danielsrualesc/CDIO3_EqE5_TELECOF/02_Hardware/Mecanica_Sistema/216c6802-5bb0-475e-80d3-5a92c7b59e43.jpeg

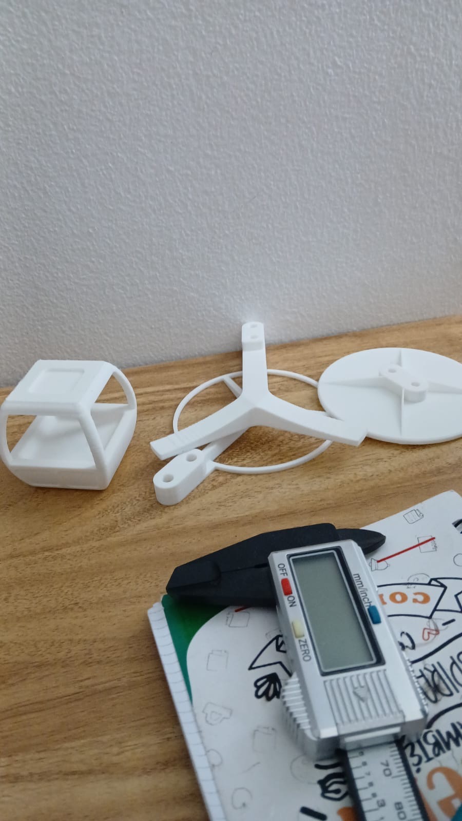
02_Hardware/Mecanica_Sistema/216c6802-5bb0-475e-80d3-5a92c7b59e43.jpeg
