danielsrualesc/CDIO3_EqE5_TELECOF/02_Hardware/Mecanica_Sistema/ec7a891b-7618-41e1-a918-f9e406c41ac0.jpeg

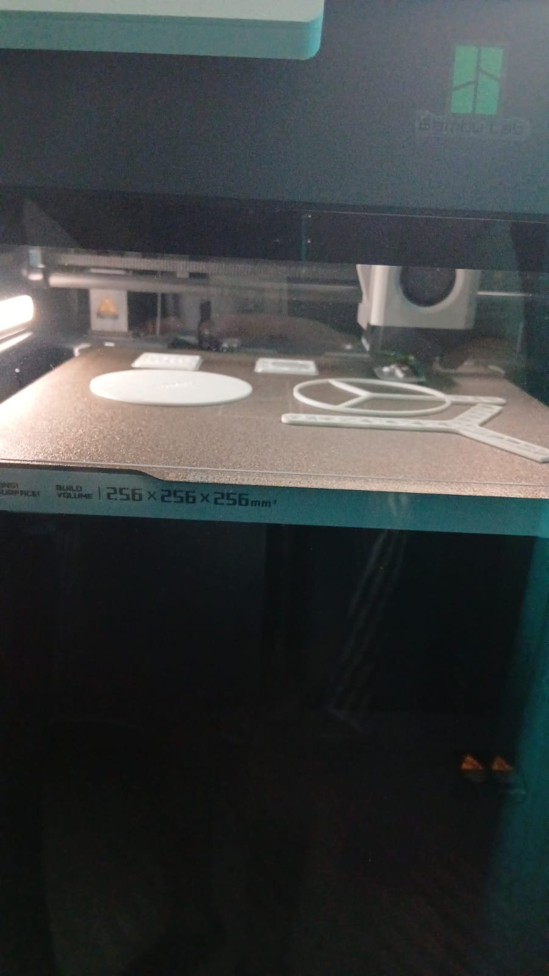
02_Hardware/Mecanica_Sistema/ec7a891b-7618-41e1-a918-f9e406c41ac0.jpeg
