danielsrualesc/CDIO3_EqE5_TELECOF/04_Dossier/Informe_Avance_.pdf

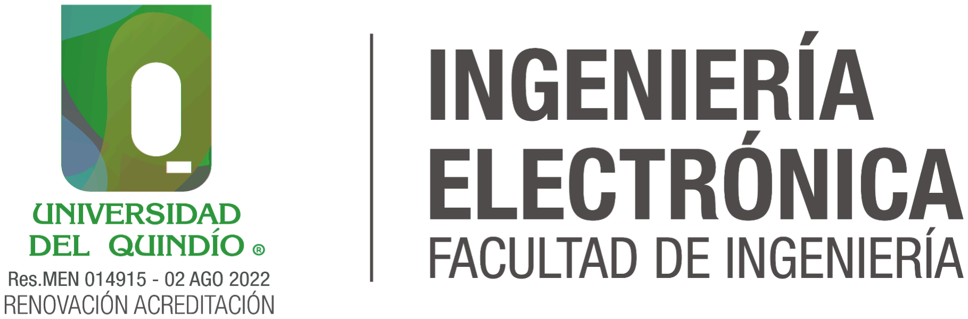
[picture p3: figure]

## FACULTAD DE INGENIERÍA PROGRAMA DE INGENIERÍA ELECTRÓNICA

## DOCUMENTO DE AUDITORÍA CDIO Informe de Avance Tecnico - PMV

## Proyecto:

### TELECOF

### Equipo de Ingeniería : Integrante 1 (Daniel MAHD Master) Integrante 2 (Kevin Daniel Hardware Lead) Integrante 3 (Erick, Robin Software Lead)

### Corte de Auditoría: Semana 12 - Fase Operación Fecha de Entrega: 4/05/2026

Universidad del Quindío
2026

## 1. Resumen Ejecutivo

Desarrollar e implementar una solución de transporte aéreo automatizado para fincas cafeteras en zonas montañosas, que permita movilizar la cosecha de forma más rápida, segura y eficiente mediante un sistema de poleas tipo teleférico. La iniciativa busca reducir la carga física del trabajador, optimizar los tiempos de traslado y mejorar la productividad general. Actualmente, el proyecto avanza en etapa de validación técnica; su continuidad dependerá de demostrar beneficios claros en desempeño, costos operativos y adaptabilidad frente a las condiciones reales del terreno.

SEMÁFORO
En estado AMARILLO
Hay advertencias o riesgos.
- Existen pequeños problemas con los tiempos para la finalización del proyecto
- Puede haber retrasos leves

HITOS TECNICOS
El mayor hito técnico alcanzado durante el último ciclo IPAC fue la construcción y validación de una maqueta funcional del sistema de transporte tipo teleférico, dice˜nada para simular el traslado de carga en terrenos inclinados propios de la caficultura.
La maqueta integra un sistema mec´anico de poleas y tracción motorizada, junto con un módulo de medición de peso, que permite cuantificar la carga transportada en tiempo real. Esta implementación no solo permitió verificar el desplazamiento estable del sistema, sino también evaluar su comportamiento frente a diferentes condiciones de carga, aportando datos clave para el análisis de eficiencia y capacidad operativa. Adicionalmente, se logró una operación controlada del sistema, garantizando un movimiento continuo, reducción de vibraciones y mayor estabilidad durante el transporte. Este avance representa la transición de una etapa conceptual a una validaci´on experimental, evidenciando la viabilidad técnica del proyecto y proporcionando una base sólida para futuras mejoras en automatización y optimización del sistema.

Durante el último ciclo IPAC se logró la integración completa del sistema a escala, alcan-Realizando el 100 por ciento del ensamblaje de la maqueta del sistema de transporte tipo teleférico. La implementación incluye un motor eléctrico, una polea de tracción, estructura de soporte, cableado y un microcontrolador ESP32 encargado del control del sistema.
El prototipo opera de extremo a extremo sin interrupciones, validando el funcionamiento continuo del mecanismo de desplazamiento de carga. Adicionalmente, se integró un sistema de medición basado en un sensor de peso con un rango de medición de hasta 6 g, cuyos datos son visualizados en tiempo real mediante una pantalla LCD, permitiendo monitoreo directo durante la operación.
El sistema funciona en modo automático, ejecutando el transporte de carga sin intervención manual durante el ciclo de operación. Para la validaci´on del prototipo, se realizaron pruebas experimentales enfocadas en dos variables: peso transportado y capacidad máxima de carga. Aunque el número de pruebas fue limitado, se logró verificar la estabilidad del sistema bajo las condiciones evaluadas.

Durante las pruebas realizadas no se registraron fallas en el funcionamiento mecánico ni en la adquisición de datos del sensor, evidenciando consistencia en la operación del sistema. Este resultado confirma la correcta integración entre los componentes mec´nicos y electr´onicos, y establece una base funcional para futuras pruebas orientadas a ampliar el rango de medición, aumentar la capacidad de carga y optimizar el desempeño general del sistema.
Está orientado a la movilización de carga en terrenos inclinados, con aplicaci´on en caficultura y otros entornos agrícolas. Su objetivo es reducir el esfuerzo f´ısico requerido por los operarios y Optimizar el traslado de productos entre puntos de difícil acceso.

ESTADO DEL PROYECTO

Actualmente, el proyecto presenta un avance del 60 porciento y se encuentra en fase de validación. Se ha logrado la construcción e integración completa de una maqueta funcional que incorpora un sistema mec´anico con motor, polea y estructura de soporte, junto con un sistema electrónico basado en un microcontrolador ESP32. Adicionalmente, se integró un sensor de peso con visualización en pantalla LCD, permitiendo monitoreo en tiempo real durante la operación. En términos de desempe˜no, el sistema recorre una distancia de 1 metro en 11 segundos bajo condiciones de prueba. Se realizaron 2 pruebas experimentales enfocadas en la evaluación de transporte y carga, alcanzando una capacidad aproximada de 10 g. Durante estas pruebas no se registraron fallas en el funcionamiento del sistema, evidenciando estabilidad operativa en el prototipo.
El impacto del sistema se refleja en la reducción directa del esfuerzo f´ısico de los trabajadores y en la optimización del proceso de transporte en actividades agrícolas. Como siguiente etapa, se plantea ampliar el número de pruebas, mejorar la precisi´on del sistema de medición de peso y realizar validaciones en condiciones m´as cercanas a un entorno real de operación.

## 2. Estado de Cumplimiento ON-Ramp

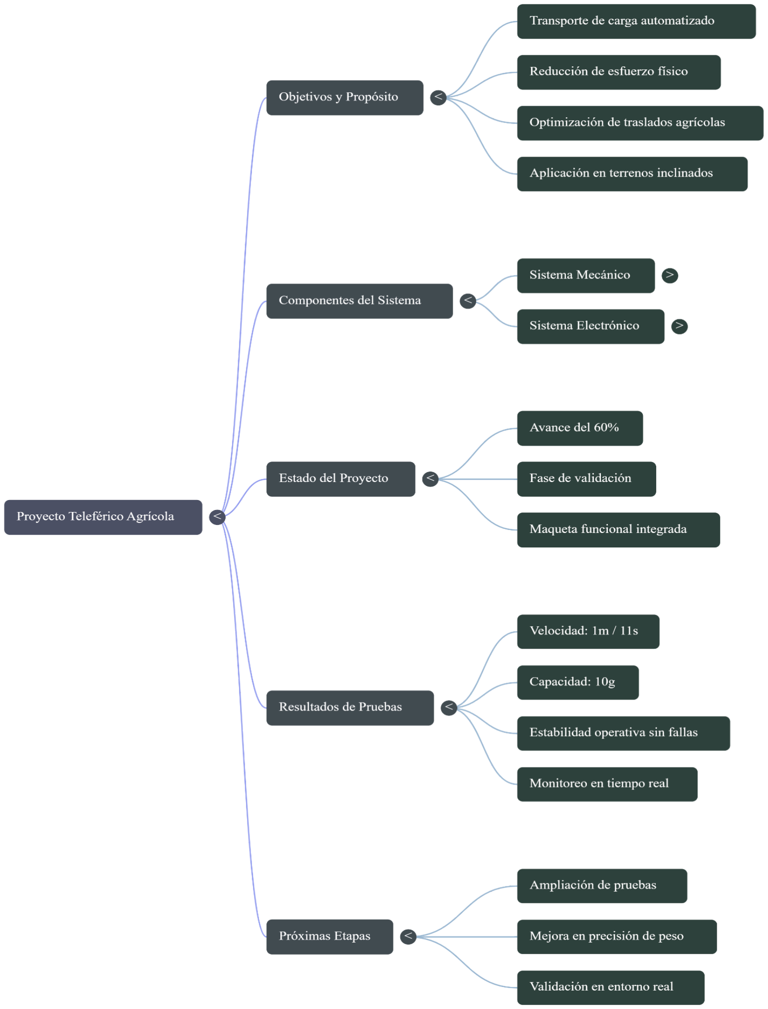
[picture p4: figure]

Figura 1 Matriz de enfoque

## 2.0.1. Requisitos críticos del sistema (PMV)

Funcionamiento continuo del sistema de transporte El sistema debe completar el recorrido de transporte de carga en una distancia de 1 metro sin interrupciones, con una tasa de éxito mínima del 90 % en al menos 10 ejecuciones consecutivas. Integración total del sistema mecánico y electrónico El 100 % de los componentes (motor, polea, estructura, cableado y ESP32) deben estar ensamblados e interconectados, permitiendo la operación completa desde inicio hasta fin del recorrido.

Automatización del ciclo de transporte
El sistema debe ejecutar el proceso de transporte de manera automática, sin intervención manual durante el desplazamiento de la carga. Medición de peso en tiempo real
El sistema debe medir y mostrar el peso de la carga mediante sensor, con visualización en pantalla LCD durante la operación. Capacidad m´ınima de carga El sistema debe transportar una carga m´ınima de 10 g sin pérdida de estabilidad ni detención del sistema.
Tiempo máximo de recorrido El sistema debe completar el recorrido de 1 metro en un tiempo igual o menor a 11 segundos. Estabilidad operativa
El sistema no debe presentar fallas mecánicas ni eléctricas durante al menos 2 pruebas consecutivas (condición actual), con meta de ampliación a 10 pruebas. Consistencia en medici´on
La variaci´on en la medición del sensor de peso no debe superar ±10 % respecto al valor esperado en condiciones controladas. Visualización de datos
El sistema debe mostrar informaci´on de peso en pantalla LCD de forma legible y continua durante el ciclo de operación. Escalabilidad del prototipo
El dise˜no debe permitir modificaciones futuras en capacidad de carga y longitud del sistema sin rediseñar completamente la estructura.

## 3. Resultados de Verificación y Validación (V&V)

El sensor de peso presenta una variación aproximada del ±10 % respecto a la medicíon esperada en cargas cercanas a 10 g, debido a la falta de calibración fina.

ID Requisito ON-Ramp Criterio de aceptación Implementación

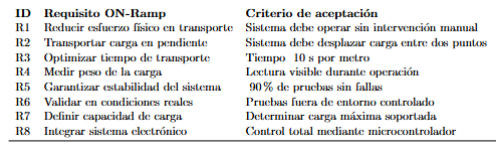
[picture p5: figure]

El sistema completa un recorrido de 50 cm en 1.5 segundos, lo que corresponde a una velocidad promedio de 0.09 m/s. El prototipo fue evaluado en 2 pruebas consecutivas sin fallas, lo que representa una tasa de éxito del 100 % en la muestra actual.

El sistema soporta una carga aproximada de 10 g sin pérdida de estabilidad ni interrupciones en el movimiento. El módulo de medición muestra datos en tiempo real con una frecuencia de actualización continua durante el ciclo de operación (sin interrupciones visibles).
El sistema opera de forma automática durante el 100 % del ciclo de transporte, sin intervention manual.
La comunicación y control mediante ESP32 se mantiene activa durante toda la operación, sin Pérdida de señal en pruebas de corto alcance (entorno controlado).

Todo resultado reportado como ”´Éxito”debe tener una evidencia física (foto, video, log, captura) en la sección de Anexos. Referencie cada prueba con su evidencia correspondiente (Ej: ”Ver evidencia en Anexo A.1”). métricas de éxito y los puntos de fallo detectados durante las pruebas de integraci´on en laboratorio.
Tasa de funcionamiento: 2/2 pruebas completadas sin fallas → 100 por ciento en la muestra actual
Distancia recorrida:1 metro por ciclo
Tiempo de recorrido:1.5 segundos por metro Velocidad promedio:0.09 m/s Capacidad de carga evaluada:10 g sin interrupciones
Nivel de automatizaci´on:100 por ciento del ciclo sin intervención manual Disponibilidad del sistema:Operación continua durante las pruebas (sin detenciones registradas)
Visualización de datos:Lectura de peso en tiempo real en pantalla LCD durante el 100 % del ciclo
Integraci´on del sistema:100 % de componentes (motor, polea, ESP32, sensor, LCD) operativos en conjunto
3.0.1. Puntos de fallo / limitaciones detectadas Tama˜no de muestra insuficiente:Solo 2 pruebas realizadas, lo que no permite validar confiabilidad estadística (objetivo 10 pruebas). Capacidad de carga no caracterizada:El valor de 10 g es estimado, no se realiz´o prueba incremental para determinar el límite máximo real. Precisión del sensor no calibrada:Se estima una variación de hasta ±10 por ciento en la medición por ausencia de calibración formal. Falta de validación en entorno real:Todas las pruebas se realizaron en condiciones controladas de laboratorio. Sin medición de consumo energético:No se registraron datos de voltaje/corriente (ej. 12 V) durante la operación.
7
Sin evaluaci´on de comunicaci´on WiFi:No se realizaron pruebas de transmisi´on de datos, latencia o pérdida de conexión. Ausencia de pruebas de estrés:No se evaluó el comportamiento del sistema bajo cargas repetitivas o funcionamiento prolongado.

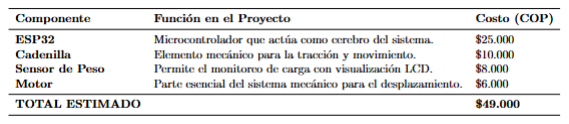
[picture p6: figure]

Tabla de presupuestos

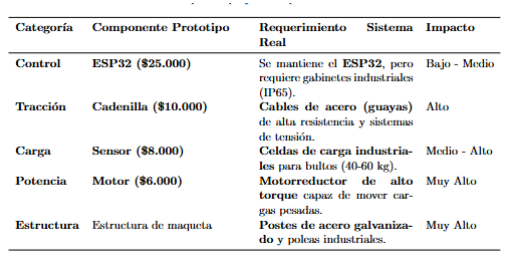
[picture p7: figure]

Presupuesto proyectado para un sistema real

Requisitos cr´ıticos del sistema (PMV) Funcionamiento continuo del sistema de transporte El sistema debe completar el recorrido de transporte de carga en una distancia de 1 metro sin interrupciones, con una tasa de ´exito m´ınima del 90 % en al menos 10 ejecuciones consecutivas.
Integraci´on total del sistema mec´anico y electr´onico El 100 % de los componentes (motor, polea, estructura, cableado y ESP32) deben estar ensamblados e interconectados, permitiendo la operaci´on completa desde inicio hasta fin del recorrido.
Automatizaci´on del ciclo de transporte
El sistema debe ejecutar el proceso de transporte de manera autom´atica, sin intervenci´on manual durante el desplazamiento de la carga. Medici´on de peso en tiempo real
El sistema debe medir y mostrar el peso de la carga mediante sensor, con visualizaci´on en pantalla LCD durante la operaci´on. Capacidad m´ınima de carga El sistema debe transportar una carga m´ınima de 10 g sin p´erdida de estabilidad ni detenci´on del sistema.
Tiempo m´aximo de recorrido El sistema debe completar el recorrido de 1 metro en un tiempo igual o menor a 11 segundos.
Estabilidad operativa
El sistema no debe presentar fallas mec´anicas ni el´ectricas durante al menos 2 pruebas consecutivas (condici´on actual), con meta de ampliaci´on a 10 pruebas.
5
Consistencia en medici´on
La variaci´on en la medici´on del sensor de peso no debe superar ±10 % respecto al valor esperado en condiciones controladas. Visualizaci´on de datos
El sistema debe mostrar informaci´on de peso en pantalla LCD de forma legible y continua durante el ciclo de operaci´on. Escalabilidad del prototipo
El dise˜no debe permitir modificaciones futuras en capacidad de carga y longitud del sistema

Requisitos cr´ıticos del sistema (PMV) Funcionamiento continuo del sistema de transporte El sistema debe completar el recorrido de transporte de carga en una distancia de 1 metro sin interrupciones, con una tasa de ´exito m´ınima del 90 % en al menos 10 ejecuciones consecutivas.
Integraci´on total del sistema mec´anico y electr´onico El 100 % de los componentes (motor, polea, estructura, cableado y ESP32) deben estar ensamblados e interconectados, permitiendo la operaci´on completa desde inicio hasta fin del recorrido.
Automatizaci´on del ciclo de transporte
El sistema debe ejecutar el proceso de transporte de manera autom´atica, sin intervenci´on manual durante el desplazamiento de la carga. Medici´on de peso en tiempo real
El sistema debe medir y mostrar el peso de la carga mediante sensor, con visualizaci´on en pantalla LCD durante la operaci´on. Capacidad m´ınima de carga El sistema debe transportar una carga m´ınima de 10 g sin p´erdida de estabilidad ni detenci´on del sistema.
Tiempo m´aximo de recorrido El sistema debe completar el recorrido de 1 metro en un tiempo igual o menor a 11 segundos.
Estabilidad operativa
El sistema no debe presentar fallas mec´anicas ni el´ectricas durante al menos 2 pruebas consecutivas (condici´on actual), con meta de ampliaci´on a 10 pruebas.
5
Consistencia en medici´on
La variaci´on en la medici´on del sensor de peso no debe superar ±10 % respecto al valor esperado en condiciones controladas. Visualizaci´on de datos
El sistema debe mostrar informaci´on de peso en pantalla LCD de forma legible y continua durante el ciclo de operaci´on. Escalabilidad del prototipo El dise˜no debe permitir modificaciones futuras en capacidad de carga y longitud del sistema

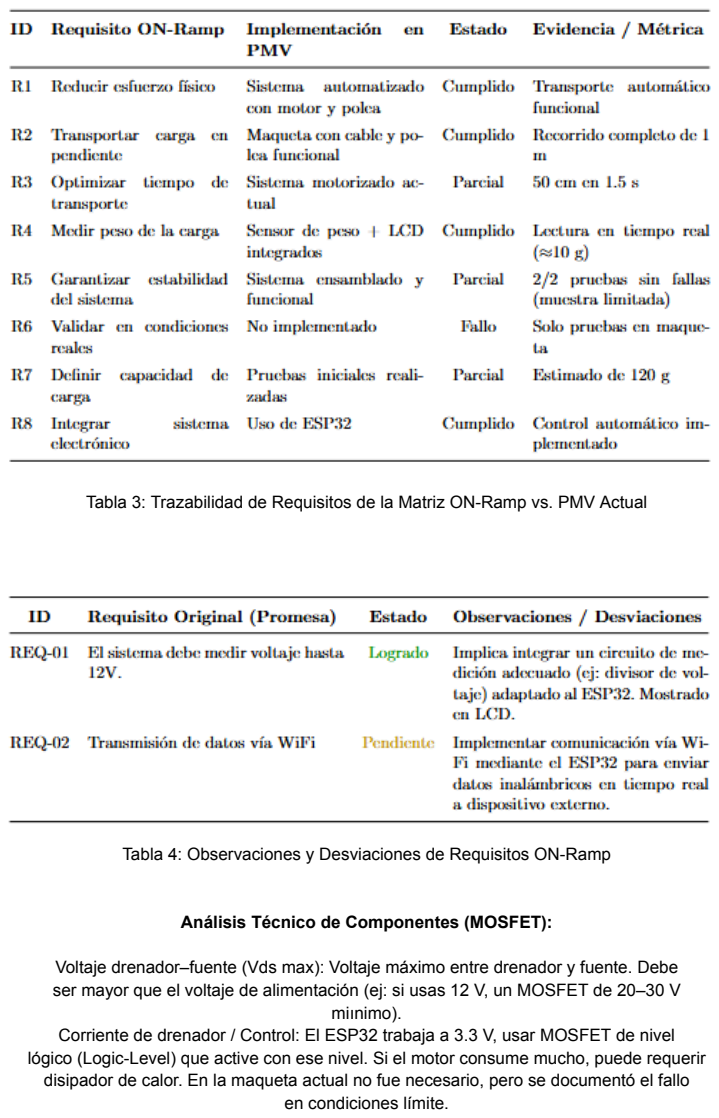
[picture p8: page 8]

Tabla 3: Trazabilidad de Requisitos de la Matriz ON-Ramp vs. PMV Actual

Tabla 4: Observaciones y Desviaciones de Requisitos ON-Ramp

Análisis Técnico de Componentes (MOSFET):

Voltaje drenador–fuente (Vds max): Voltaje máximo entre drenador y fuente. Debe ser mayor que el voltaje de alimentación (ej: si usas 12 V, un MOSFET de 20–30 V miınimo).
Corriente de drenador / Control: El ESP32 trabaja a 3.3 V, usar MOSFET de nivel lógico (Logic-Level) que active con ese nivel. Si el motor consume mucho, puede requerir disipador de calor. En la maqueta actual no fue necesario, pero se documentó el fallo en condiciones límite.

## 4. Desempeño Operativo MAHD

Métricas de Alto Desempeño. El sistema presenta un desempe˜no operativo medido mediante m´etricas de tiempo (11 s/m), capacidad (≈10 g) y confiabilidad (100 % en 2 pruebas), evidenciando funcionalidad en entorno controlado. El análisis Kanban muestra un avance completo en la construcci´on e integraci´on del sistema, con actividades en curso enfocadas en validación experimental y calibración.
Resumen de Indicadores Operativos: Eficiencia: Tiempo de ciclo 11 s por 1 m. Velocidad promedio 0.09 m/s. Confiabilidad: 2 pruebas ejecutadas, 2 exitosas (Tasa de ´exito 100 % limitada). Capacidad: Carga transportada ≈10 g. Fallas registradas: 0 durante pruebas.

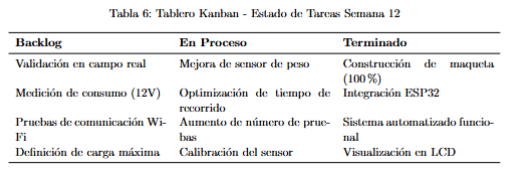
[picture p9: figure]

## 4.1. Gestiion de Flujo y Cuellos de Botella

Construcción de maqueta → Terminado (100 %): Estructura desarrollada con madera, papel maché y soportes. Implementación de montana y sistema de polea. Integración del sistema → En Proceso: Programación del ESP32. L´ogica de activaci´on del sensor de peso (condición: peso valido → movimiento). Instalación de cableado interno. Validación → Backlog / En Proceso: Pruebas de funcionamiento (2 realizadas). Va-Validación en campo no ejecutada. Se manejó una limitaci´on impl´ıcita de trabajo en proceso, manteniendo maximo 2–3 tareas simultáneas en estado “En Proceso”, enfocadas en la programación del sensor, integración y ajustes de control. Esto permitió evitar dispersión y priorizar la finalización.

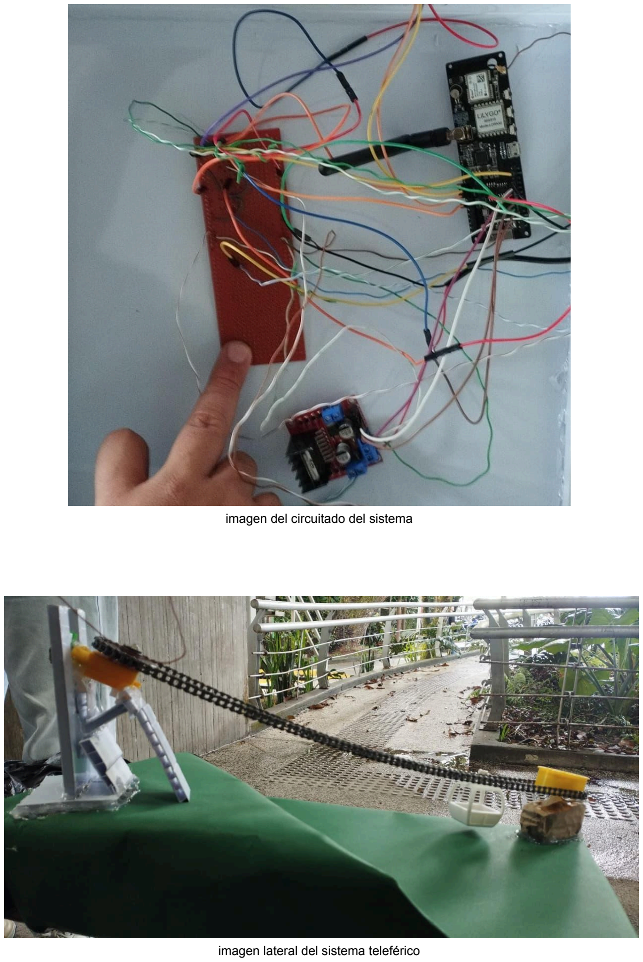
[picture p10: page 10]

imagen del circuitado del sistema

imagen lateral del sistema teleférico

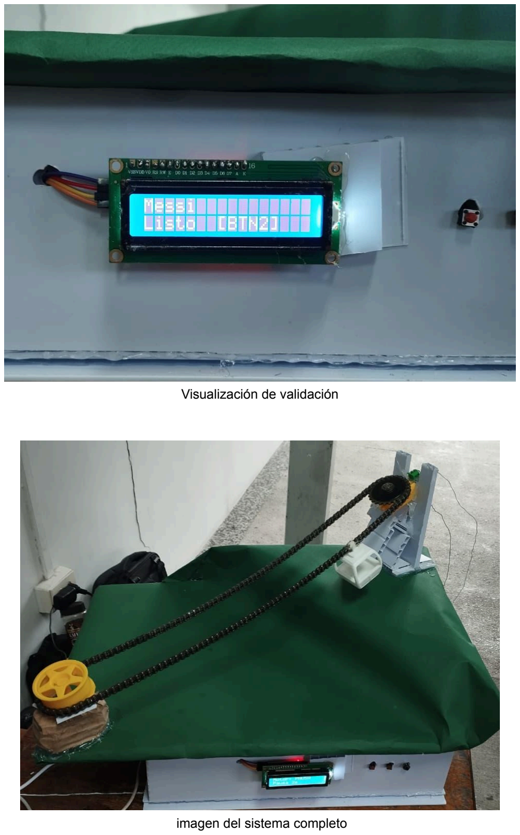
[picture p11: page 11]

Visualización de validación

imagen del sistema completo
