danielsrualesc/CDIO3_EqE5_TELECOF/04_Dossier/DocumentacionDiseño.pdf

OBJETIVO GENERAL
Desarrollar una solución de un sistema electromecánico que optimice el transporte de café en cultivos de ladera, mejorando las condiciones de trabajo y la eficiencia del proceso productivo.
OBJETIVOS ESPECIFICOS
- Medir el peso de la carga en cada punto de acopio, garantizando lecturas confiables y repetibles para el registro de café entregado.
- Visualizar el valor económico correspondiente a lo pesado por cada trabajador, a partir del peso registrado y la tarifa definida, generando un registro por entrega y un acumulado por jornada.
- Controlar el desplazamiento de la carga mediante el sistema de transporte, asegurando movimiento estable y seguro en ladera (arranque/parada, regulación de velocidad y funciones básicas de seguridad) para mantener un flujo eficiente hacia el sitio de descarga.
REQUERIMIENTOS FUNCIONALES
- El sistema debe medir el peso de la carga en cada punto de acopio.
- El sistema debe permitir realizar tara/cero para descontar el peso del recipiente o costal.
- El sistema debe validar el pesaje (por ejemplo, detectar lectura estable) antes de guardar el registro.
- El sistema debe registrar cada entrega con: identificación del trabajador, punto de acopio, fecha/hora y peso neto.
- El sistema debe permitir configurar la tarifa de pago (por kgkg, arroba u otra unidad definida).
- El sistema debe calcular automáticamente el valor a pagar por entrega a partir del peso y la tarifa.
- El sistema debe visualizar al usuario el peso registrado y el valor calculado por entrega.
- El sistema debe llevar un acumulado por jornada por trabajador (peso total y valor total) y permitir consultarlo.
- El sistema debe generar un historial de entregas por trabajador para revisión del administrador.
- El sistema debe permitir corregir/anular un registro bajo autorización, guardando trazabilidad del cambio (quién y por qué).
- El sistema debe controlar el desplazamiento de la carga (arranque, parada y control de velocidad).
- El sistema debe incluir paro de emergencia para detener el transporte de forma inmediata.
- El sistema debe indicar el estado del sistema de transporte (listo, en movimiento, detenido, falla/alarma).
REQUERIMIENTOS NO FUNCIONALES

- El sistema de pesaje debe cumplir precisión y repetibilidad definidas para el proyecto.
- El tiempo de respuesta para estabilizar y mostrar el peso y el valor no debe superar
3s en condiciones normales.
- La interfaz debe ser legible en exteriores y fácil de usar, permitiendo completar un registro de entrega con pocos pasos.
- El sistema debe ser resistente a condiciones de campo (polvo, salpicaduras y vibración), con protección.
- El sistema debe priorizar seguridad: limitar velocidad máxima, evitar arranques inesperados y asegurar frenado seguro ante pérdida de energía.
- El sistema debe operar de forma confiable durante una jornada de trabajo/prueba definida sin fallas críticas.
- El sistema debe conservar los datos ante cortes de energía (almacenamiento no volátil) y permitir exportación de registros.
- El acceso a funciones críticas (cambiar tarifa, anular registros) debe estar restringido (PIN, perfil o llave).
- El mantenimiento debe ser simple (componentes reemplazables, limpieza sencilla y acceso a partes clave).
- El diseño debe ser viable para construcción como maqueta con presupuesto y componentes disponibles para el curso.

RESTRICCIONES DEL PROYECTO
- El sistema debe operar con bultos típicos de café de ~65 kg y no debe permitir cargas que superen la capacidad máxima definida del transporte (180 kg), ya que esto compromete la seguridad y el desempeño.
- La solución debe adaptarse a cultivos en ladera con terreno irregular, húmedo y resbaladizo, por lo que el diseño no puede depender de superficies perfectamente planas ni de infraestructura pesada.
- Por tratarse de un sistema tipo teleférico, la implementación queda condicionada a la disponibilidad de puntos de anclaje/soporte (postes o estructuras) y a mantener el cable con tensión adecuada para evitar deslizamientos o inestabilidad.
- El cálculo del pago por trabajador depende de una tarifa definida por el administrador; el sistema solo puede estimar el valor según esa tarifa y no puede validar condiciones externas (bonos, calidad, descuentos) si no se modelan explícitamente.
- El diseño debe minimizar el impacto ambiental y la intervención del terreno; esto limita obras civiles extensas y obliga a una infraestructura ligera y desmontable.

### FUNCIONES DEL SISTEMA

- Recibir y gestionar la entrega de café en puntos de acopio (habilitar el punto de recepción, guiar la operación de pesaje y confirmar la entrega).
- Medir el peso neto de cada carga (incluye tara/cero y verificación de estabilidad de la lectura).
- Identificar al trabajador asociado a la entrega (para poder asignar correctamente los kilos y el pago).
- Registrar la transacción de entrega (guardar trabajador, punto de acopio, fecha/hora, peso neto y observaciones si aplica).
- Calcular el valor a pagar por entrega usando la tarifa definida y el peso registrado.
- Mostrar al trabajador y/o encargado el resultado (peso, valor de la entrega y acumulado de la jornada).
- Consolidar acumulados por jornada (total de kg y total a pagar por trabajador; opcional: total general de la finca/día).
- Permitir administración del sistema (configurar tarifa, crear/editar trabajadores, habilitar puntos de acopio, consultar históricos).
- Gestionar correcciones/anulaciones con autorización y trazabilidad (quién cambia, qué cambia, por qué y cuándo).
- Transportar la carga desde el punto de acopio hasta el punto de descarga mediante el sistema tipo teleférico.
- Controlar el desplazamiento del transporte (arranque, parada, control de velocidad y sentido si aplica).
- Supervisar la seguridad del transporte (detectar condición de riesgo básica: sobrecarga, parada de emergencia activada, condición anormal de movimiento; activar retención/frenado).
- Ejecutar paro de emergencia y llevar el sistema a un estado seguro.
- Indicar estados y alarmas (listo, operando, detenido, falla/emergencia) de forma visible para el operario.
- Generar reportes/exportación de datos (por jornada, por trabajador, por punto de acopio) para control y soporte de decisiones.
ESTABLECER FUNCIONES

Subfunción
principal

CTQ (qué
se mide)

Meta / especificación
objetivo

Verificación
(cómo se
comprueba)

Criterio de
aceptación

1) Recepción e identificació n | Trazabilidad por trabajador | Cada entrega queda asociada a un trabajador y a un punto de acopio (ID trabajador + punto + fecha/hora) | Simulación con 2–3 trabajadores y 10 entregas | 100% de registros correctamente asignados
2) Pesaje de carga en acopio | Rango y calidad de medición | Rango 0–200 kg; exactitud ±0.5 a ±1.0 kg; repetibilidad ≤ ±0.5 kg; tara funcional | Pesos patrón / cargas conocidas (incluye ~65 kg y carga alta) y repetición de lecturas | Cumple exactitud y repetibilidad definidas; no satura en el rango
3) Cálculo y visualizació n de pago | Cálculo correcto y claridad | Cálculo automático Pago=Peso×Tarifa; muestra peso, tarifa, pago y acumulado por jornada | Pruebas con 3–5 casos numéricos y revisión en pantalla | 0 errores de cálculo; información entendible para operario
4) Registro y gestión de datos | Integridad y control | Guarda historial por entrega; acumulado por jornada; exportación (CSV o reporte); cambios críticos con autorización y trazabilidad | Corte de energía + reinicio; exportación; intento de cambio sin permiso | No se pierden datos; exportación legible; cambios restringidos y registrados
5) Transporte tipo teleférico | Capacidad y desempeño de traslado | Capacidad máx. 180 kg por viaje; control arranque/parada y velocidad (mín. 2 niveles) | Prueba con carga equivalente y recorrido de maqueta | Traslada sin fallas críticas y responde a comandos
6) Seguridad operacional | Detención segura | Paro de emergencia con rearme manual; retención/frenado que evite retroceso no controlado al detenerse en pendiente | Activar E-stop en movimiento; parada en pendiente con carga | Se detiene y queda en estado seguro; no reinicia solo

GENERAR ALTERNATIVAS

Función / Subfunción | Alternativa 1 | Alternativa 2 | Alternativa 3 | Alternativa 4
Transporte (arquitectura) | Teleférico monocable (carro colgado) | Bicable (portante + tractor) | Cable + riel guía (híbrido) | Winche + polea con plataforma (tipo “malacate”)
Tracción / accionamient o | Motor DC + reductor | Motor AC + variador (VFD) | Motor BLDC + controlador | Winche manual asistido (solo maqueta)
Sistema de frenado | Freno mecánico por fricción (tambor/disco) | Freno electromagnétic o | Autoretención por tornillo sin fin (reductor) | Sistema “anti-retroceso” (trinquete/rued a libre)
Control de movimiento | Interruptores: subir/bajar/paro | Control PWM con perilla de velocidad | Control cerrado con encoder (velocidad) | Control con perfiles (arranque suave)
Seguridad (paros y límites) | Paro de emergencia + finales de carrera | Paro + sensor tensión cable | Paro + limitación por sobrecorrient e | Paro + sensor de velocidad (overspeed)
Carro / sujeción de carga | Gancho + eslinga | Canastilla rígida | Plataforma con barandas | Bolsa en contenedor (caja)
Punto de acopio (pesaje) | Báscula con celda de carga + estructura | Báscula comercial adaptada | Celda de carga en el gancho (suspensión) | Celda en el carro (peso en movimiento no recomendado)

Identificación del trabajador | Manual (selección en pantalla) | Tarjeta RFID | Código QR | PIN por trabajador
Visualización | Pantalla LCD simple | Pantalla OLED | Tablet/celular (app) | Impresora térmica + display mínimo
Registro de datos | SD card (CSV) | Memoria interna + descarga | Envío Bluetooth a celular | WiFi a hoja de cálculo/servidor
Cálculo de pago | En microcontrolado r | En app móvil | En hoja de cálculo exportada | En pantalla + reporte al final

MODELAR Y ANALIZAR ALTERNATIVAS
1) Alternativas
Concepto | Transporte | Control + seguridad | Pesaje + pago | Enfoque
A (Base / CDIO 3) | Teleférico monocable + carro | Motor DC + reductor, control PWM (velocidad), freno mecánico de retención, paro de emergencia | Pesaje fijo en acopio, ID manual, cálculo Pago=Peso×Tarifa, registro digital | Balance entre desempeño y facilidad de implementar
B (Robusto / futuro) | Bicable o monocable instrumentad o | Motor BLDC, freno fail-safe, realimentación (sensor velocidad), más protecciones | Pesaje fijo, RFID/QR, reportes más completos | Mejor seguridad y trazabilidad, pero más complejo/caro

C (Simple /
económico)

Winche–pole
as
(malacate)

Interruptores
(subir/bajar/parar
), freno
mecánico

Báscula comercial,
registro y cálculo
semi-manual

Rápido y
barato, pero
menos
automatizació
n y
trazabilidad
2) Modelado rápido por objetivos
Objetivo específico | A | B | C
Medir peso confiable en acopio (bultos ~65 kg) | Alto (pesaje fijo, fácil estabilizar) | Alto (pesaje fijo + mejor instrumentación) | Medio (depende más del operador)
Visualizar pago por trabajador y acumulados | Medio–alto (ID manual + registros) | Alto (RFID/QR + reportes) | Bajo–medio (más manual)
Controlar desplazamiento seguro (capacidad objetivo 180 kg) | Alto (control suficiente + freno/retención) | Muy alto (mejor seguridad y control) | Medio (más dependencia humana)
3) Matriz de selección (Pugh compacta) Escala: + mejor que A, 0 igual, − peor que A.
Criterio | Peso | A (Base) | B | C
Seguridad en ladera (freno/retención/E-stop) | 5 | 0 | + | −
Escalabilidad a 180 kg (concepto real) | 5 | 0 | + | −
Control de velocidad y maniobra | 4 | 0 | + | −

Trazabilidad del pago por trabajador | 4 | 0 | + | −
Viabilidad CDIO 3 (tiempo, integración) | 5 | 0 | − | +
Costo y disponibilidad de componentes | 4 | 0 | − | +
Riesgo técnico de no terminar | 4 | 0 | − | +

Lectura rápida:
- B gana en desempeño/seguridad, pero pierde en costo/tiempo y riesgo de implementación en el semestre.
- C gana en rapidez/costo, pero se queda corto en automatización, trazabilidad y escalabilidad a 180 kg.
- A queda como el mejor equilibrio para CDIO 3.
4) Decisión
Se selecciona el Concepto A como alternativa de implementación en CDIO 3 por su balance entre integración completa (pesaje + pago + control del transporte), seguridad suficiente para maqueta y viabilidad de construcción en el tiempo del curso. El Concepto B se deja como ruta de evolución (mayor seguridad e instrumentación) y el Concepto C como alternativa de contingencia por simplicidad, aunque con limitaciones en trazabilidad y automatización.
