danielsrualesc/CDIO3_EqE5_TELECOF/04_Dossier/DiagramaIDEF-0.pdf

Café recolectado en bultos (65 kg).
Carga entregada en el punto de acopio.

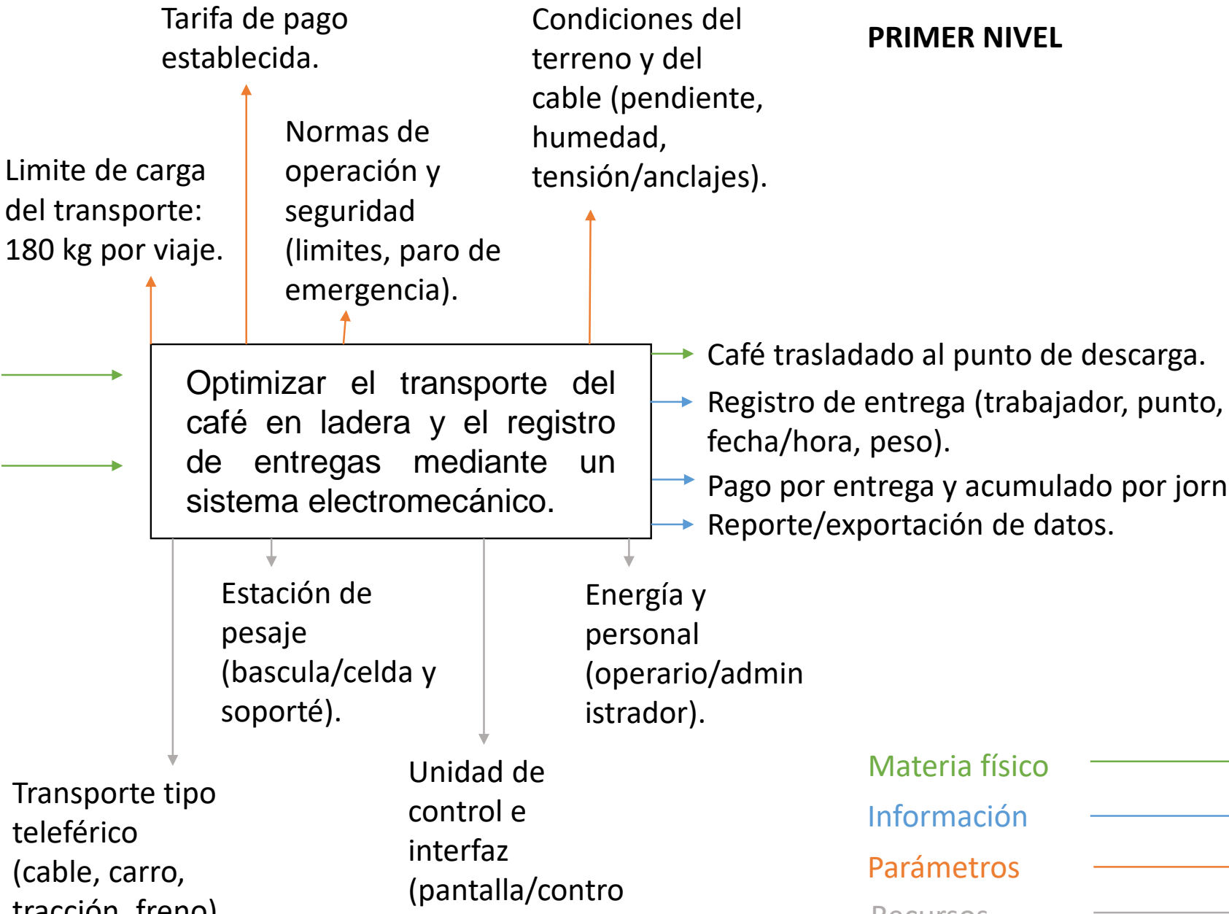
[picture p12: figure]
Optimizar el transporte del café en ladera y el registro de entregas mediante un sistema electromecánico.; Limite de carga del transporte: 180 kg por viaje.; Tarifa de pago establecida.; Normas de operación y seguridad (limites, paro de emergencia).; Condiciones del terreno y del cable (pendiente, humedad, tensión/anclajes).; Café trasladado al punto de descarga. Registro de entrega (trabajador, punto, fecha/hora, peso).; Reporte/exportación de datos.; Transporte tipo teleférico (cable, carro,; Estación de pesaje (bascula/celda y soporté).; Unidad de control e interfaz (pantalla/contro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

Pago por entrega y acumulado por jornada.

tracción, freno).
les).

Recursos

Materia físico
Información
Parámetros

Control Motores

Energía
Datos
Control

Algoritmo de
control

Movimiento
controlado
(Rotación del
eje).
Moto reductor
700 RPM (12V)

Procesar Información

Energía
Datos
Peso

Datos pantalla

ESP 32

Señal
Pulsador

Control Motor

Datos | Identificar Trabajador Estructura HTML/CSS/JS

Visualizar
Información
| Servidor ESP 32

SEGUNDO NIVEL

Materia físico
Información
Parámetros

Mostrar Datos Energía

Protocolo I2C

Visualizar
Información

Interfaz

Datos
Digitales

LCD 16X2 I2C

Pesaje de carga Energía

Protocolo
(Serial/SPI)

Datos peso
principal Peso

Celda de carga
+Hx711

SEGUNDO NIVEL

TERCER NIVEL
SUBFUNCIONES DE
MOSTRAR DATOS Recibir datos del ESP32

Datos digitales procesados (Peso, pago, acumulado)

Materia físico
Información
Parámetros

Protocolo I2C

Datos listos
para formatear

Modulo I2C del
LCD

Formatear
información para
pantalla

Datos recibidos

Estructura de
visualización

Texto formateado
(línea 1: peso; línea 2:
pago)

Librería LCD +
microcontrolador

Mostrar en
pantalla

Texto formateado

Refresco de
pantalla
(timing)

Información
visible para el
operario

Pantalla LCD
16x2 I2C

SUBFUNCIONES DE
PESAJE DE CARGA Aplicar tara/cero Señal de inicio de pesaje

Materia físico
Información
Parámetros

Comando de tara del operario

Valor de referencia cero
establecido

HX711 + celda
de carga

Formatear
información para
pantalla

Señal amplificada

Protocolo
Serial/SPI;
umbral de
estabilidad

Datos de peso digital
estable (en kg)

HX711 + ESP32

Capturar señal
del sensor

Fuerza física de la
carga (peso bruto)

Ganancia del
amplificador
HX711

Señal analógica
amplificada

Celda de carga
+ HX711

SUBFUNCIONES DE
PESAJE DE CARGA

Materia físico
Información
Parámetros

Capturar señal
del sensor

Datos de peso
digital

Criterio de lectura estable (variación < umbral)

Peso neto validado →
enviado a "Procesar
Información"

ESP32

SUBFUNCIONES DE
CONTROL MOTORES Recibir orden de movimiento

Datos de control
(subir/parar/bajar)

Materia físico
Información
Parámetros

Algoritmo de control del ESP32

Señal de dirección y
activación

ESP32 + driver
de motor

Ejecutar paro de
emergencia Señal de pulsador de emergencia

Prioridad
máxima sobre
cualquier otra
orden

Corte inmediato de
energía al motor;
sistema detenido

ESP32 + relay/driver +
freno mecánico

Accionar
motoreductor

Señal de dirección
y activación

Límite de
velocidad
(700 RPM /
12V)

Rotación del eje
(movimiento
del carro)

Motoreductor
700RPM 12V

SUBFUNCIONES DE
PROCESAR
INFORMACION

Leer entradas
del sistema

Datos peso (HX711),
señal pulsador, datos
trabajador

Materia físico
Información
Parámetros

Protocolo de comunicación
(Serial/SPI/WiFi)

Variables internas
actualizadas (peso, ID,
estado)
ESP32

Generar órdenes
de control Estado del sistema + señal pulsador

Algoritmo de
control
definido

Control motor
(subir/parar) + datos
pantalla

ESP32

Calcular pago

Peso neto
validado + tarifa
configurada

Pago = Peso ×
Tarifa

Valor de pago
por entrega +
acumulado

ESP32 (lógica
de software)

SUBFUNCIONES DE
IDENTIFICAR
TRABAJADOR

Servir interfaz
web

Datos del sistema
(trabajadores
registrados, entregas)

Materia físico
Información
Parámetros

Estructura HTML/CSS/JS

Página web accesible
para identificar al
trabajador
Servidor
ESP32

Visualizar historial
y acumulados

Registros
almacenados (peso,
pago, entregas)

Filtro por
trabajador/jornada

Información visible
para administrador
(historial, pagos,
totales)

ESP32 + interfaz
web (HTML/CSS/JS)

Registrar selección del
trabajador

Selección del
operario en la
interfaz web

Lista de
trabajadores
disponibles

ID trabajador
seleccionado

Servidor ESP32
+ cliente web
