danielsrualesc/CDIO3_EqE5_TELECOF/PLANTILLA_CHECKLIST/README.md

## CHECKLIST DE DEFINICIÓN DE HECHO (DoD) — PROYECTO TELEFÉRICO DE CAFÉ

Antes de cerrar esta tarea y moverla a **"Done"**, certifico como integrante responsable que se han validado los siguientes criterios en el sistema base del **Teleférico de Café**:

### ⚡ 1. HARDWARE
- [x] **Esquemático/Conexiones:** El diagrama de conexiones del sistema electrónico fue actualizado y validado sin errores de integración.
- [x] **Continuidad Eléctrica:** Se verificó ausencia de cortocircuitos en líneas de alimentación y comunicación.
- [x] **Integración Física:** Sensores, microcontrolador, motores y actuadores se encuentran correctamente conectados y asegurados.
- [x] **Métricas Eléctricas:** El sistema recibe alimentación estable y todos los módulos operan dentro del rango de voltaje esperado.

### 💻 2. FIRMWARE / SOFTWARE
- [x] **Compilación Limpia:** El código del sistema compila sin errores críticos en el entorno de desarrollo utilizado.
- [x] **Funcionamiento del Control:** El teleférico responde correctamente a las instrucciones de operación y monitoreo.
- [x] **Repositorio:** El código fuente y avances del proyecto se encuentran respaldados y organizados.
- [x] **Trazabilidad:** Las modificaciones y cambios realizados durante el desarrollo fueron documentados correctamente.

### ⚙️ 3. MECÁNICA / DISEÑO DE LA MAQUETA
- [x] **Archivos Fuente:** Los diseños y evidencias del sistema mecánico se encuentran organizados en la carpeta `mecanica_sistema/`.
- [x] **Integridad de la Maqueta:** La estructura del teleférico fue ensamblada correctamente y soporta el funcionamiento del sistema.
- [x] **Movimiento Mecánico:** Se validó el desplazamiento adecuado del sistema de transporte sin bloqueos ni fallos mecánicos.
- [x] **Tolerancias:** Se verificó que todos los componentes encajan correctamente dentro de la estructura diseñada.

### 📋 4. GESTIÓN Y PRUEBAS
- [x] **BOM Actualizado:** Todos los componentes electrónicos, mecánicos y estructurales están registrados en la lista de materiales del proyecto.
- [x] **Protocolo de Pruebas:** Se realizaron pruebas de funcionamiento del sistema completo y fueron documentadas.
- [x] **Evidencias del Proyecto:** Fotografías, videos y registros del desarrollo fueron almacenados en `mecanica_sistema/`.
- [x] **Aprobación:** El sistema fue validado funcionalmente y cumple con los objetivos establecidos del proyecto.

---

✅ **Estado Final del Proyecto:** **PASS**  
**Proyecto Teleférico de Café — Sistema Automatizado de Transporte y Monitoreo**
