danielsrualesc/CDIO3_EqE5_TELECOF/02_Hardware/Mecanica_Sistema/README.md

# ⚙️ Mecánica del Sistema — Evidencias del Desarrollo

Esta carpeta contiene las **evidencias del proceso de diseño, construcción y ensamblaje mecánico** del sistema **TELESFÉRICO DE CAFÉ**.

Aquí se documenta el desarrollo físico de la **maqueta del teleférico cafetero**, incluyendo pruebas, modificaciones estructurales y avances realizados durante la implementación del sistema.

---

## 📸 Contenido de la carpeta

En esta sección se encuentran almacenadas las evidencias relacionadas con:

- Diseño y construcción de la **estructura del teleférico**
- Desarrollo de la **maqueta física**
- Ensamble mecánico del sistema
- Montaje de componentes electrónicos
- Integración del sistema de pesaje
- Pruebas de funcionamiento del mecanismo
- Ajustes y mejoras durante el desarrollo
- Registro fotográfico y visual del proyecto

---

## 🎯 Objetivo de esta documentación

El propósito de esta carpeta es **mostrar el proceso evolutivo del proyecto**, evidenciando el desarrollo mecánico y estructural realizado para lograr el funcionamiento del sistema **TELESFÉRICO DE CAFÉ**, desde sus primeras fases hasta la implementación final.

Estas evidencias permiten validar el proceso de diseño, fabricación e integración del sistema desarrollado.

---

## 📂 Estructura de evidencias

```txt
mecanica_sistema/
│── fotos_maqueta/
│── estructura_teleferico/
│── montaje_componentes/
│── pruebas_mecanicas/
│── ajustes_y_mejoras/
└── evidencias_finales/
```

---

*TELESFÉRICO DE CAFÉ © 2026 — Evidencias de Desarrollo Mecánico*
