danielsrualesc/CDIO3_EqE5_TELECOF/04_Dossier/DASHBOARD/README.md

# 📊 Dashboard MAHD: Estructura y Automatización  
**Proyecto:** Teleférico de Café | **Estado:** Validado y Consolidado | **Autor:** Equipo de Desarrollo

---

## 📋 Descripción General
El **Dashboard MAHD** es la herramienta centralizada de control, seguimiento y validación del proyecto **Teleférico de Café**, diseñada para garantizar la correcta integración entre los sistemas electrónicos, mecánicos y de automatización desarrollados durante el proyecto.

Este tablero permite consolidar la documentación técnica, evidencias experimentales, validaciones de funcionamiento y pruebas realizadas sobre la maqueta y el sistema automatizado del teleférico, asegurando la trazabilidad completa del proceso de diseño e implementación.

🔗 **Dashboard MAHD — Google Sheets**  
https://docs.google.com/spreadsheets/d/1BPqoi0OXagbAaEim1T4lUMFV-VwAkPPGX0HjGa50tf4/edit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

---

## 🎯 Objetivos del Dashboard
1. **Validación Integral:** Garantizar que el sistema del teleférico cumple con los requisitos funcionales, electrónicos y mecánicos establecidos para el proyecto.
2. **Trazabilidad del Desarrollo:** Mantener el historial del diseño de la maqueta, pruebas de funcionamiento, integración de sensores y control del sistema.
3. **Control de Calidad (QA):** Registrar evidencias técnicas y validar el correcto desempeño del teleférico durante las pruebas experimentales.

---

## 🧩 Estructura de la Documentación Validada

El dashboard centraliza y valida las siguientes áreas del proyecto:

### 1. Electrónica y Control del Sistema
* [x] Integración del microcontrolador y sensores del sistema.
* [x] Validación del funcionamiento del control del teleférico.
* [x] Monitoreo de estados operativos del sistema.
* [x] Verificación de estabilidad eléctrica y alimentación.

### 2. Diseño Mecánico y Maqueta
* [x] Construcción estructural de la maqueta del teleférico.
* [x] Validación de estabilidad mecánica y resistencia estructural.
* [x] Integración de componentes electrónicos dentro del sistema.
* [x] Registro fotográfico y evidencias de construcción almacenadas en `mecanica_sistema`.

### 3. Operación y Validación Experimental
* [x] Pruebas de funcionamiento del sistema de transporte.
* [x] Validación de movimiento continuo del teleférico.
* [x] Registro de incidencias y correcciones realizadas.
* [x] Consolidación del **Definition of Done (DoD)** del proyecto.

---

## 🛠️ Instrucciones de Uso y Mantenimiento
Debido a que el proyecto se encuentra en fase de **Validación y Consolidación**, el dashboard se utilizará como herramienta principal de consulta y trazabilidad.

* Toda evidencia del proceso de diseño, construcción y validación debe registrarse dentro de las hojas correspondientes.
* Las métricas y resultados experimentales del proyecto deben extraerse directamente del dashboard para mantener coherencia documental.
* La carpeta **`mecanica_sistema`** contiene las evidencias visuales del desarrollo de la maqueta y la implementación del sistema del teleférico.
* Se recomienda no modificar fórmulas ni estructuras internas del dashboard para conservar la integridad de la documentación histórica.

---

**Proyecto Teleférico de Café © 2025 — Sistema Automatizado de Transporte de Café**
