danielsrualesc/CDIO3_EqE5_TELECOF/04_Dossier/DEFINITION_DONE/README.md

# 🚀 Definition of Done (DoD) — Proyecto Teleférico de Café
**Versión:** 1.0 (Final) | **Fecha de actualización:** 2026-05-18  
**Estado:** Finalizado y Consolidado | **Autor:** Equipo de Desarrollo

---

## 🎯 Criterios de Aceptación Globales
Todos los módulos e iteraciones del sistema fueron desarrollados y validados bajo criterios técnicos, mecánicos y funcionales para garantizar la correcta operación del teleférico automatizado.

| # | Criterio | Estándar de Verificación | Estado |
|---|---|---|:---:|
| 1 | **Integridad del Sistema** | Correcta integración de hardware, sensores y control del teleférico sin errores críticos. | ✅ |
| 2 | **Validación Física** | Funcionamiento exitoso de la maqueta bajo pruebas operativas de transporte. | ✅ |
| 3 | **Integración del Proyecto** | Todos los módulos electrónicos, mecánicos y estructurales ensamblados correctamente. | ✅ |
| 4 | **Revisión del Equipo** | Validación funcional por parte del grupo de trabajo y asesor académico. | ✅ |
| 5 | **Evidencia Experimental** | Registro fotográfico, videos y pruebas documentadas en carpeta `mecanica_sistema`. | ✅ |

---

## 🛠️ Criterios Técnicos Específicos Cumplidos

### 1. Firmware & Control del Sistema (FW)
Se garantizó la estabilidad del sistema de control y monitoreo del teleférico, permitiendo la supervisión del transporte de café de manera segura.

| Ref | Requisito Técnico | Parámetro de Éxito Alcanzado | Estado |
|---|---|---|:---:|
| **FW-01** | **Lectura de Sensores** | Monitoreo estable de variables físicas mediante sensores integrados. | ✅ |
| **FW-02** | **Control del Sistema** | Activación y respuesta correcta de actuadores y elementos del teleférico. | ✅ |
| **FW-03** | **Visualización de Estado** | Datos mostrados correctamente en interfaz de monitoreo/pantalla. | ✅ |

### 2. Hardware & Integración Mecánica (HW)
Se validó la estructura física del teleférico, garantizando estabilidad mecánica y correcta integración de los componentes.

| Ref | Requisito Técnico | Parámetro de Éxito Alcanzado | Estado |
|---|---|---|:---:|
| **HW-01** | **Integridad Estructural** | Maqueta ensamblada correctamente sin fallas mecánicas durante operación. | ✅ |
| **HW-02** | **Integración Electrónica** | Correcta conexión entre ESP32, sensores, alimentación y actuadores. | ✅ |
| **HW-03** | **Alimentación Estable** | Sistema funcionando sin caídas de voltaje o reinicios inesperados. | ✅ |

### 3. Sistema Integrado & Operación (MC)
Se validó el comportamiento global del teleférico bajo condiciones simuladas de transporte.

| Ref | Requisito Técnico | Parámetro de Éxito Alcanzado | Estado |
|---|---|---|:---:|
| **MC-01** | **Funcionamiento del Teleférico** | Movimiento continuo y estable del sistema de transporte. | ✅ |
| **MC-02** | **Seguridad Operacional** | Operación sin desprendimientos, bloqueos ni interrupciones críticas. | ✅ |
| **MC-03** | **Retroalimentación del Usuario** | Indicadores visuales/sonoros funcionando correctamente para informar el estado del sistema. | ✅ |

---

## 🏁 Cierre del Proyecto y Conformidad
El proyecto **Teleférico de Café** se declara **Terminado y Consolidado**. Todas las pruebas funcionales, mecánicas y electrónicas fueron realizadas satisfactoriamente, garantizando la correcta integración del sistema automatizado de transporte.  

Además, toda la evidencia del proceso de diseño, construcción de la maqueta, pruebas y validaciones quedó registrada en la carpeta **`mecanica_sistema`**, permitiendo la trazabilidad completa del desarrollo del proyecto.

**Teleférico de Café © 2025 — Sistema Automatizado de Transporte de Café**
