danielsrualesc/CDIO3_EqE5_TELECOF/02_Hardware/Datasheets/ README.md

# 📑 Datasheets y Documentación Técnica

Esta carpeta contiene la documentación técnica oficial de los componentes utilizados en el sistema **TELESFÉRICO DE CAFÉ**.

Todos los documentos aquí almacenados corresponden a **datasheets oficiales de fabricante**, especificaciones técnicas y documentación necesaria para el correcto diseño electrónico, programación del firmware y configuración del sistema de comunicación **LoRa + WiFi**.
