danielsrualesc/CDIO3_EqE5_TELECOF/04_Dossier/MatrizDeDefensaDeDiseño(MDD).pdf

En esta matriz estamos haciendo una “defensa” del diseño del sistema.

Tomamos los puntos más importantes del proyecto –como medir bien el peso, calcular el pago, mover el café por cable y mantener la seguridad– y revisamos qué dice nuestro diseño sobre cada uno.

Para cada aspecto explicamos, en palabras simples, qué propone el sistema, si eso cumple o no con lo que se necesita y qué acciones faltan para mejorar o comprobarlo.

De esta forma la matriz muestra que el diseño no es solo un dibujo, sino que ya fue analizado, justificado y tiene un plan claro de siguientes pasos.

Nº | Qué estamos defendiendo | ¿Qué muestra nuestro diseño? | Evaluación | Qué vamos a hacer después
1 | Propósito del proyecto | El sistema recibe el café en la ladera, lo pesa, registra la entrega por trabajador y luego lo mueve por cable hasta el punto de descarga. Todo esto está conectado en un solo flujo. | Cumplido: la solución realmente junta transporte, pesaje y registro, que es lo que promete el proyecto. | Mantener esta idea central y evitar cambios que separen estas tres partes.
2 | Que el peso sea confiable | Usamos una celda de carga con el módulo HX711; el diseño incluye poner en cero (tara), leer la señal del sensor, filtrar la lectura y validar el peso antes de guardarlo. | Bien planteado, falta probar: en papel está correcto, pero tenemos que confirmar la precisión con pesos reales. | Hacer pruebas con bultos de café y pesos patrón, ajustar la calibración y anotar el error máximo y el tiempo que tarda en estabilizar.
3 | Que el pago se calcule y se muestre bien | El sistema toma el peso neto, aplica la tarifa y calcula de forma automática cuánto gana el recolector. Muestra el | Cumplido: el proceso de “identificar, pesar, calcular, mostrar y guardar” está | Probar varios ejemplos de peso y tarifa para revisar que los números en pantalla coinciden con el cálculo.

Nº | Qué estamos defendiendo | ¿Qué muestra nuestro diseño? | Evaluación | Qué vamos a hacer después
| | resultado en una pantalla y guarda el acumulado de la jornada. Cada entrega queda asociada a un trabajador. | completo y es entendible.
4 | Tener registros claros y trazables | Se guarda quién entregó, en qué punto, a qué hora y con qué peso. Además, desde una interfaz web sencilla se pueden ver los historiales y los totales por trabajador o por jornada. | Parcialmente cumplido: la idea de trazabilidad está, pero falta detallar mejor cómo se guardan los datos si se va la energía y cómo se exportan. | Definir el formato de archivo (por ejemplo, CSV) y cómo se hace la copia de seguridad de los registros para que no se pierdan.
5 | Que el transporte funcione de forma estable | Elegimos un sistema tipo teleférico con motor reductor. El control permite encender, apagar y regular la velocidad del movimiento del carro sobre el cable. | Adecuado para maqueta: permite demostrar el movimiento controlado y la capacidad de transporte en el prototipo. | Medir velocidad, par y capacidad con carga simulada, y dejar claros los límites de operación que no se deben superar.
6 | Seguridad del transporte en pendiente | El diseño contempla freno mecánico, posible apoyo con freno eléctrico y un paro de emergencia que corta la energía al motor. La idea es que el carro no se devuelva en la | Punto crítico: las soluciones están pensadas, pero todavía hay que comprobar en la práctica que realmente frenan y sostienen la carga. | Diseñar y ejecutar pruebas específicas en pendiente: ensayo de retroceso, frenado con carga y prueba del botón de emergencia. Documentar resultados.

Nº | Qué estamos defendiendo | ¿Qué muestra nuestro diseño? | Evaluación | Qué vamos a hacer después
| | pendiente y se detenga de forma segura.
7 | Que el sistema se adapte a la ladera real | El diseño considera bultos de 65 kg y una capacidad máxima de 180 kg por viaje. Usa estructuras relativamente ligeras y un solo cable, evitando obras pesadas y superficies totalmente planas. | Cumplido: respeta los límites de carga y se adapta a un terreno inclinado y húmedo, típico de un cultivo de café. | En el prototipo, montar la estructura con una inclinación representativa y revisar posibles puntos débiles (por ejemplo, corrosión o flexión excesiva).
8 | Facilidad de uso para recolector y administrador | El recolector interactúa con una pantalla sencilla y pocos pasos. El administrador puede usar una interfaz web básica para ver datos y hacer ajustes. Se plantea restringir cambios importantes como la tarifa. | Aceptable: la interfaz parece manejable, pero todavía se puede mejorar en claridad de mensajes y seguridad de acceso. | Hacer una mini prueba con usuarios (compañeros), observar dónde se confunden y ajustar textos, orden de pantallas y mecanismo de clave o PIN.
9 | Que se pueda construir dentro del curso | Entre varias alternativas se eligió una opción que combina todas las funciones, pero usa componentes accesibles (motor DC, teleférico simple, pesaje fijo en acopio). Se | Sólido: el alcance es realista para el tiempo y el presupuesto del semestre, siempre que se respete el plan. | Fijar un cronograma por módulos (pesaje, control, transporte, interfaz) y dejar las mejoras avanzadas como opcionales.

Nº | Qué estamos defendiendo | ¿Qué muestra nuestro diseño? | Evaluación | Qué vamos a hacer después
| | evitaron soluciones más complejas y costosas.
10 | Riesgo global del proyecto | Los principales riesgos identificados son: seguridad del transporte, confiabilidad del pesaje y posibilidad de no terminar todos los módulos. El diagrama funcional ayuda a ver cómo se conectan y dónde atacar primero. | Riesgo manejable: sabemos qué partes son más delicadas y podemos priorizarlas en el desarrollo y las pruebas. | Empezar por construir y probar pesaje y transporte, luego integrar interfaz y registros; revisar el avance periódicamente con la matriz.
