danielsrualesc/CDIO3_EqE5_TELECOF/01_Gestion/RETROALIMENTACION_FINAL/d5eed452-d040-401f-a35a-5d123eb50597.jpeg

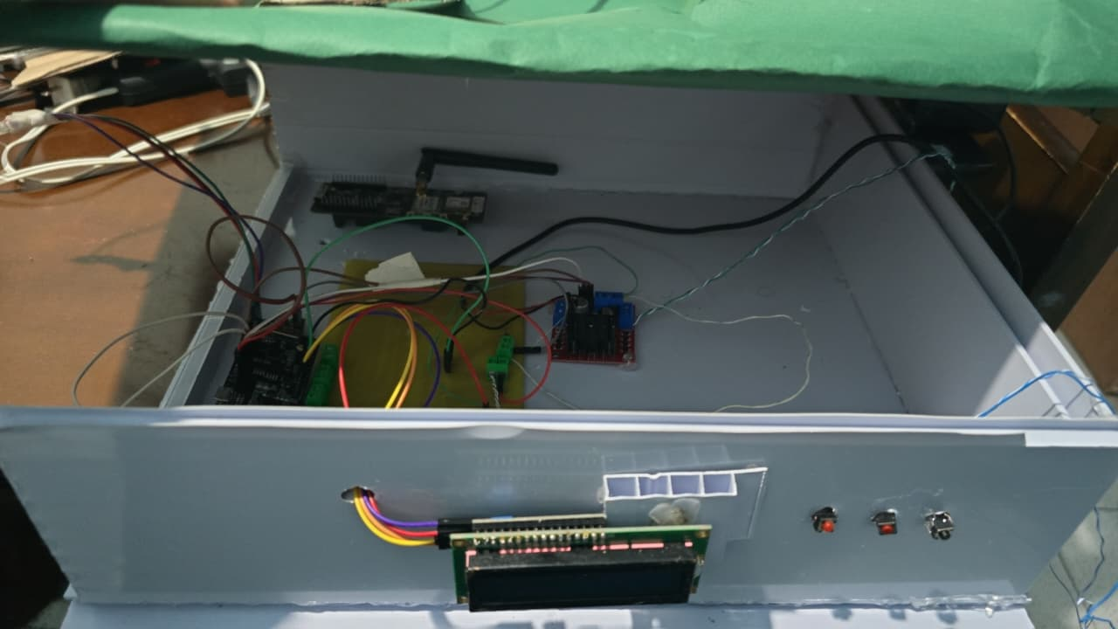
01_Gestion/RETROALIMENTACION_FINAL/d5eed452-d040-401f-a35a-5d123eb50597.jpeg
