danielsrualesc/CDIO3_EqE5_TELECOF/01_Gestion/RETROALIMENTACION_FINAL/f9e4c3b0-6c92-4315-b8c2-d4893bc5c586.jpeg

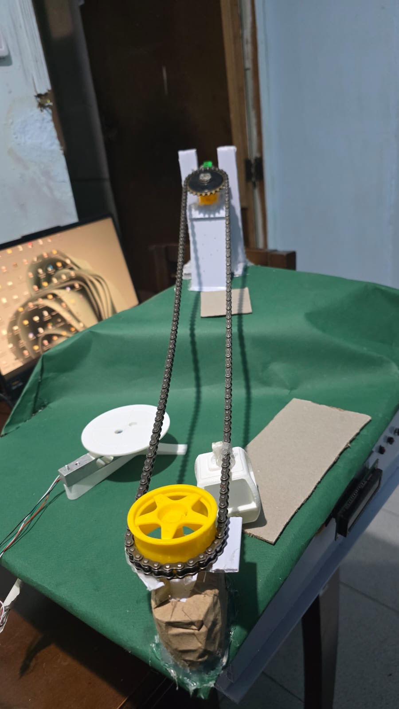
01_Gestion/RETROALIMENTACION_FINAL/f9e4c3b0-6c92-4315-b8c2-d4893bc5c586.jpeg
