danielsrualesc/CDIO3_EqE5_TELECOF/02_Hardware/Mecanica_Sistema/7E0B01E9-7844-4180-AB7C-C68F91C87D37.jpeg

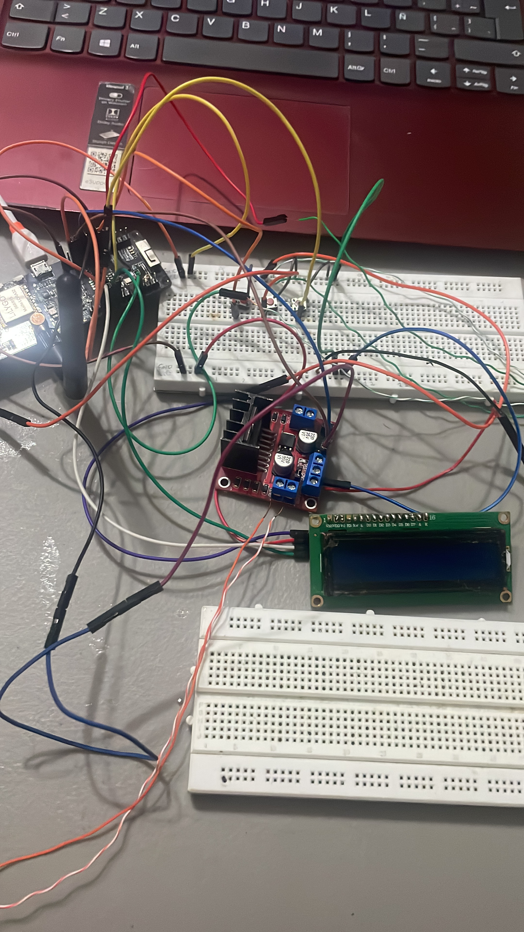
02_Hardware/Mecanica_Sistema/7E0B01E9-7844-4180-AB7C-C68F91C87D37.jpeg
