danielsrualesc/CDIO3_EqE5_TELECOF/02_Hardware/Mecanica_Sistema/9958CF04-77E5-49FA-9D3F-410EC52E2979.jpeg

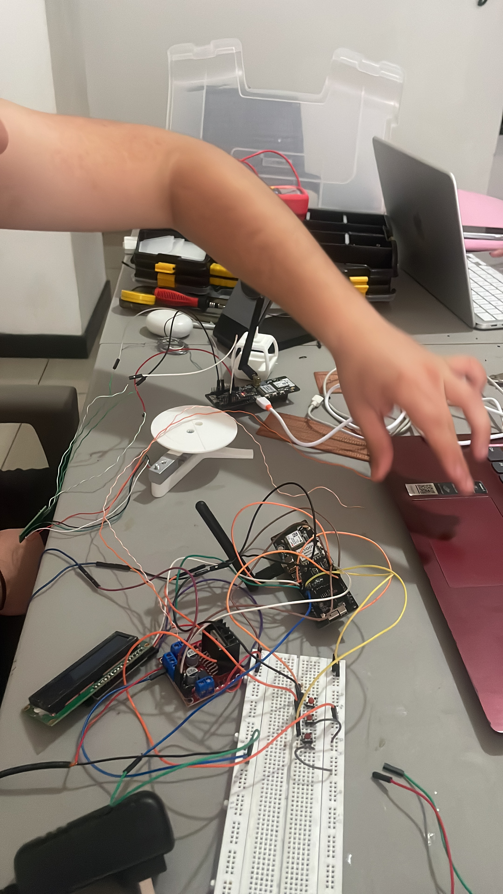
02_Hardware/Mecanica_Sistema/9958CF04-77E5-49FA-9D3F-410EC52E2979.jpeg
