danielsrualesc/CDIO3_EqE5_TELECOF/02_Hardware/Mecanica_Sistema/B5B7E205-6C00-4223-AE03-F51020EEE422.jpeg

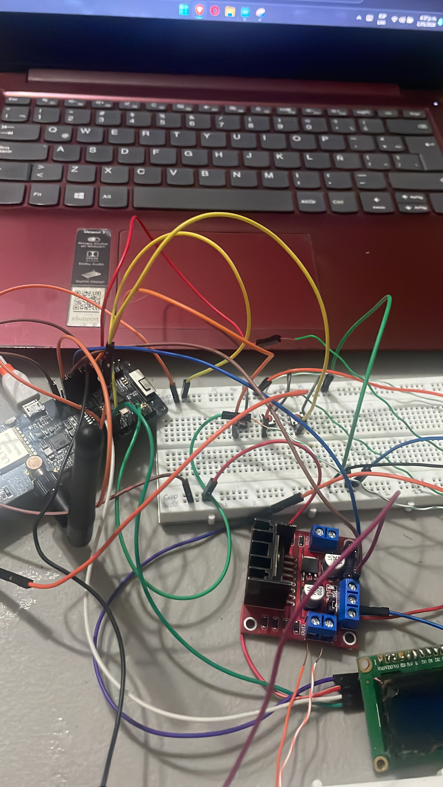
02_Hardware/Mecanica_Sistema/B5B7E205-6C00-4223-AE03-F51020EEE422.jpeg
