danielsrualesc/CDIO3_EqE5_TELECOF/02_Hardware/Mecanica_Sistema/c3aec54f-9903-473f-a646-2740f7145e35.jpeg

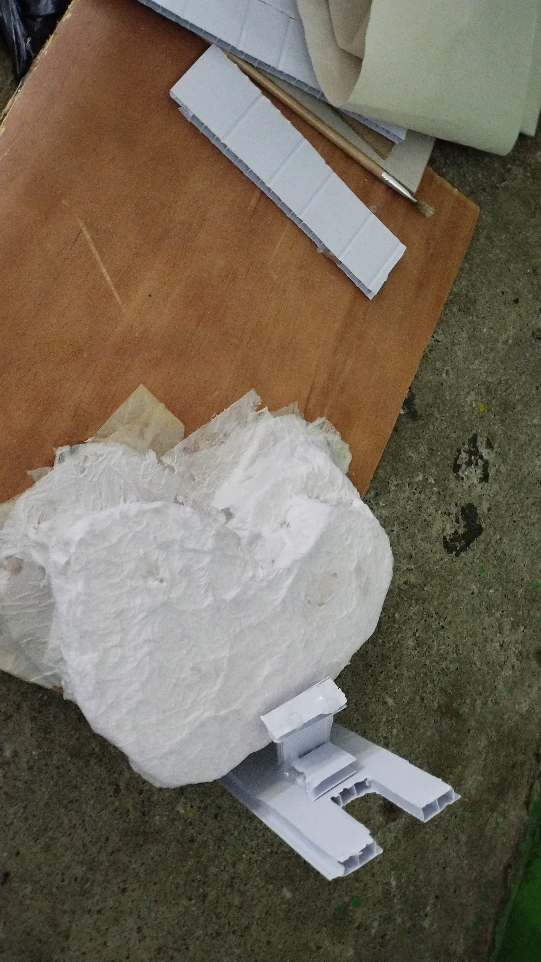
02_Hardware/Mecanica_Sistema/c3aec54f-9903-473f-a646-2740f7145e35.jpeg
