danielsrualesc/CDIO3_EqE5_TELECOF/02_Hardware/Mecanica_Sistema/c23b883d-21ad-43b8-84f0-e249eb31a92f.jpeg

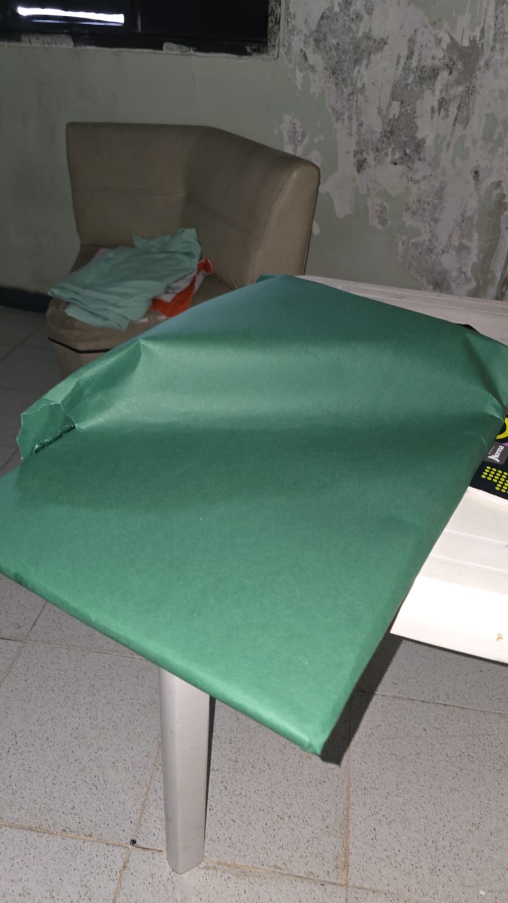
02_Hardware/Mecanica_Sistema/c23b883d-21ad-43b8-84f0-e249eb31a92f.jpeg
