danielsrualesc/CDIO3_EqE5_TELECOF/01_Gestion/Actas/Tabla_Componentes.xlsx

Ítem (Descripción) | MPN (Manufacturer Part Number) | Proveedor (Link) | Costo Unit. (COP) | Tiempo de Entrega | Semáforo de Riesgo
Microcontrolador | ESP32-S2 C3 | Universidad | $ 25.000 |  | 🟡 AMARILLO
Sensor de peso | HX711 sensor | Mercado libre | $ 10.000 | Entregado | 🟢 VERDE (En mano)
pulsadores | piulsador 4 pines | Local | $ 2.000 | Entregado | 🟢 VERDE (En mano)
pantalla LCD | LCD Shield | Local | $ 11.000 | Entregado | 🟢 VERDE (En mano)
leds | LEDS | Local | $ 2.000 | Entregado | 🟢 VERDE (En mano)
Interfaz Usuario | Buzzer + LED + Switch | Local | $ 3.500 | Entregado | 🟢 VERDE (En mano)
Manufactura | Impresión 3D PETG / PCB | Universidad / Taller | $ 15.000 | 5 Días | 🟡 AMARILLO (Pendiente)
