danielsrualesc/CDIO3_EqE5_TELECOF/PROTOCOLO_PRUEBAS/README.md

# 🧪 Protocolos de Prueba y Validación (Test Reports)

Este directorio contiene los reportes oficiales de pruebas ejecutadas para el proyecto **Teleférico de Café**. Todas las validaciones realizadas siguen un enfoque basado en **datos medibles, pruebas funcionales y criterios técnicos verificables**, permitiendo garantizar el correcto funcionamiento del sistema electromecánico desarrollado.

> 📊 **Documento Oficial:**  
https://docs.google.com/spreadsheets/d/1aRgyDsrhHfRh4J8zUgCT-kbOG-oivHNOT2VnL4wlNOE/edit?gid=0#gid=0

---

## 📌 Resumen Ejecutivo de Pruebas (Fase Actual)

A continuación, se presenta el estado de los principales test de integración realizados en el sistema (**Hardware, Firmware y Mecánica**) durante la fase de validación del prototipo funcional:

| ID Prueba | Subsistema | Objetivo Principal | Resultado Medido | Estado |
| :--- | :--- | :--- | :--- | :---: |
| **TEST-HW-01** | Estructura del Teleférico | Validar estabilidad estructural y montaje mecánico del sistema. | Estructura estable sin deformaciones ni desprendimientos durante operación. | ✅ **PASS** |
| **TEST-FW-01** | Pantalla LCD | Verificar correcta visualización de estados y mensajes del sistema. | Mensajes mostrados correctamente en tiempo real. | ✅ **PASS** |
| **TEST-FW-02** | Sistema de Movimiento | Validar funcionamiento continuo del motor del teleférico. | Movimiento estable y sin interrupciones durante pruebas funcionales. | ✅ **PASS** |
| **TEST-MC-01** | Transporte del Sistema | Validar desplazamiento correcto del mecanismo sobre el cable. | Recorrido ejecutado sin bloqueos mecánicos. | ✅ **PASS** |
| **TEST-HW-02** | Alimentación del Sistema | Verificar estabilidad energética del prototipo. | Operación continua sin apagados inesperados. | ✅ **PASS** |
| **TEST-MC-02** | Estabilidad Dinámica | Evaluar vibraciones durante el movimiento del teleférico. | Vibraciones dentro de límites aceptables sin afectar la operación. | ✅ **PASS** |

---

## ⚙️ Metodología de Validación (Definition of Done)

Para que una prueba sea marcada como `✅ PASS` y el subsistema sea validado correctamente, debe cumplir estrictamente con los siguientes criterios técnicos:

### 1. **Cero Subjetividad**
No se aceptan observaciones ambiguas como *“funcionó bien”* o *“se veía estable”*. Cada prueba debe incluir parámetros verificables, como:
- Tiempo de respuesta.
- Continuidad del movimiento.
- Estabilidad del sistema.
- Correcta visualización de datos.
- Ausencia de fallos eléctricos o mecánicos.

### 2. **Setup Documentado**
Cada prueba registrada en el protocolo incluye:
- Componentes utilizados.
- Condiciones iniciales del sistema.
- Configuración del hardware.
- Pasos de ejecución realizados.
- Parámetros de entrada definidos.

### 3. **Criterios de Aceptación Predefinidos**
El resultado esperado se establece antes de realizar la prueba, garantizando objetividad en la validación. Una prueba solo se considera aprobada cuando el sistema cumple completamente con el comportamiento esperado.

---

## 🔍 Alcance de las Validaciones

Las pruebas realizadas permiten verificar:

- ✅ Correcto funcionamiento del sistema de movimiento del teleférico.
- ✅ Estabilidad estructural de la maqueta.
- ✅ Integridad del sistema de alimentación.
- ✅ Correcta comunicación y visualización en pantalla LCD.
- ✅ Funcionamiento continuo sin bloqueos o fallos.
- ✅ Integración entre hardware, firmware y sistema mecánico.

---

*Documento mantenido por: Emerson Santiago Córdoba · Ingeniería Electrónica*
