danielsrualesc/CDIO3_EqE5_TELECOF/01_Gestion/Bitácoras Semanales/README.md

## 📓 Bitácoras de Reunión — Proyecto Teleférico del Café

Para garantizar un trabajo en equipo organizado y responsable, se realizaron bitácoras semanales donde se documenta el avance del proyecto.  
Haz clic en cada enlace para ver el detalle de cada sesión:

---

### 📊 Registro de Bitácoras

| # | Bitácora | Acceso |
|---|---|---|
| 1 | Bitácora #1 | [Ver documento](https://docs.google.com/document/d/1FFzuTpRhC-9SZDKtgnB828o9TEjjXEIbBRsSl8soRMg/edit?tab=t.0) |
| 2 | Bitácora #2 | [Ver documento](https://docs.google.com/document/d/1lksfTK__wOvCI3Vu5XlI4DHxjGqYDirc2AH4cxkRIt0/edit?tab=t.0) |
| 3 | Bitácora #3 | [Ver documento](https://docs.google.com/document/d/1LLbM6u-PThcCw7iV8MSH9bcMc4X7ju7FZqsLhkJI-k8/edit?tab=t.0) |
| 4 | Bitácora #4 | [Ver documento](https://docs.google.com/document/d/1dKUbfVVxSpsd4YnRMoXExwvPn-1yWbLWFqyzu2hREJw/edit?tab=t.0) |
| 5 | Bitácora #5 | [Ver documento](https://docs.google.com/document/d/1rk48qEX_70lmrDwtQ9zaA6fIRA1QNlsDoeiZyTnIowg/edit?tab=t.0) |
| 6 | Bitácora #6 | [Ver documento](https://docs.google.com/document/d/1eAt5F45PVoQuuC4qOYL29f5YlEFhXCAEo2f_djkXVJI/edit?tab=t.0) |
| 7 | Bitácora #7 | [Ver documento](https://docs.google.com/document/d/1Eut5q4HUCViQr3PckrUQFWic9hUujSpkMHoGCqKVxd4/edit?tab=t.0) |
| 8 | Bitácora #8 | [Ver documento](https://docs.google.com/document/d/14X8R97ckO0hSjS5OfLqrOSPbC3-jZTINkpMVLAPtDls/edit?tab=t.0) |
| 9 | Bitácora #9 | [Ver documento](https://docs.google.com/document/d/1wRi1oleFRT8gtj-eFMOBH6IomvVY7_o8BGgNyjQk3xo/edit?tab=t.0) |
| 10 | Bitácora #10 | [Ver documento](https://docs.google.com/document/d/1HSrrq-ZPikVIXIIRriFUT37tEA24jAY_qDA8qKj2si0/edit?tab=t.0) |
| 11 | Bitácora #11 | [Ver documento](https://docs.google.com/document/d/1WuKK-6usDkmacnZvdluShXe7VrJVyk7bnUayXHsRLf4/edit?tab=t.0) |
| 12 | Bitácora #12 | [Ver documento](https://docs.google.com/document/d/1q1VH2MGP5tc7nImnwXV3ylToX3Fs7j_PWfyiSymz06s/edit?tab=t.0) |
| 13 | Bitácora #13 | [Ver documento](https://docs.google.com/document/d/1Q_Sgxlpc_lhUu_Cy3HQ_WhFW4Ft_g792ppJrBBykMxw/edit?tab=t.0) |
| 14 | Bitácora #14 | [Ver documento](https://docs.google.com/document/d/1jc8Xj5QNhymPhb12MtOt-I6YFIuXigrQ67KFf5JkMe0/edit?tab=t.0) |

---

### 🧠 Nota
Estas bitácoras permiten evidenciar la trazabilidad del proyecto, la toma de decisiones y el avance progresivo del sistema **Teleférico del Café**, desde su fase conceptual hasta la integración final del sistema de pesaje agroindustrial con comunicación LoRa 915MHz.
